andersonsafre/Low-Cost-Dendrometer/hardware/dendro_bracket_v1.pdf

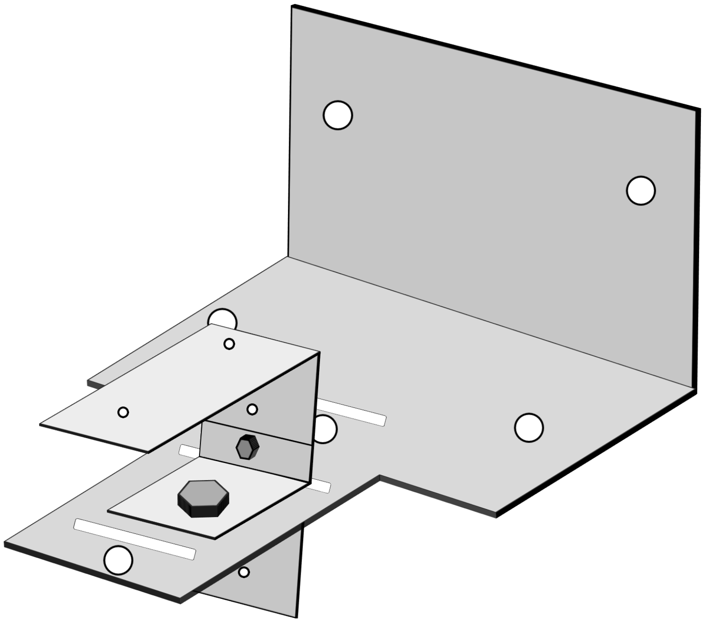
[picture p1: figure]

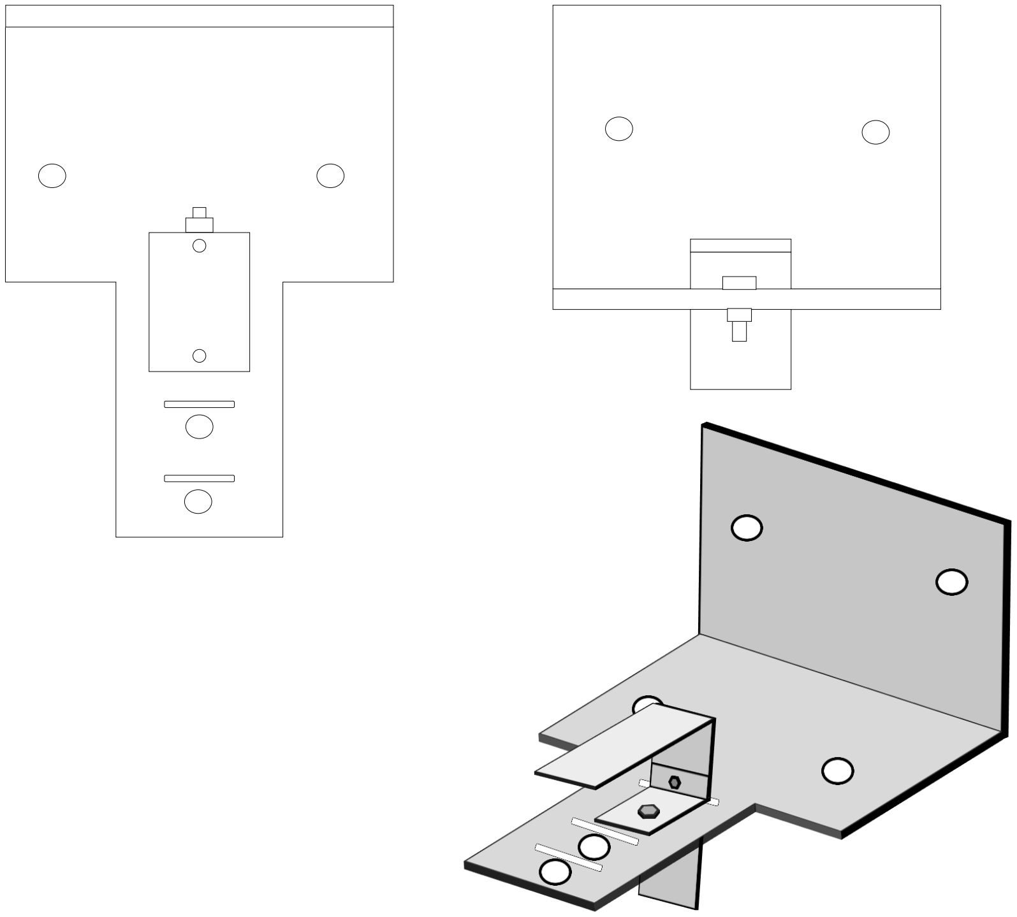
[picture p2: figure]

Part B | Part A

Part C

ø1/4”

# Ø2 mm

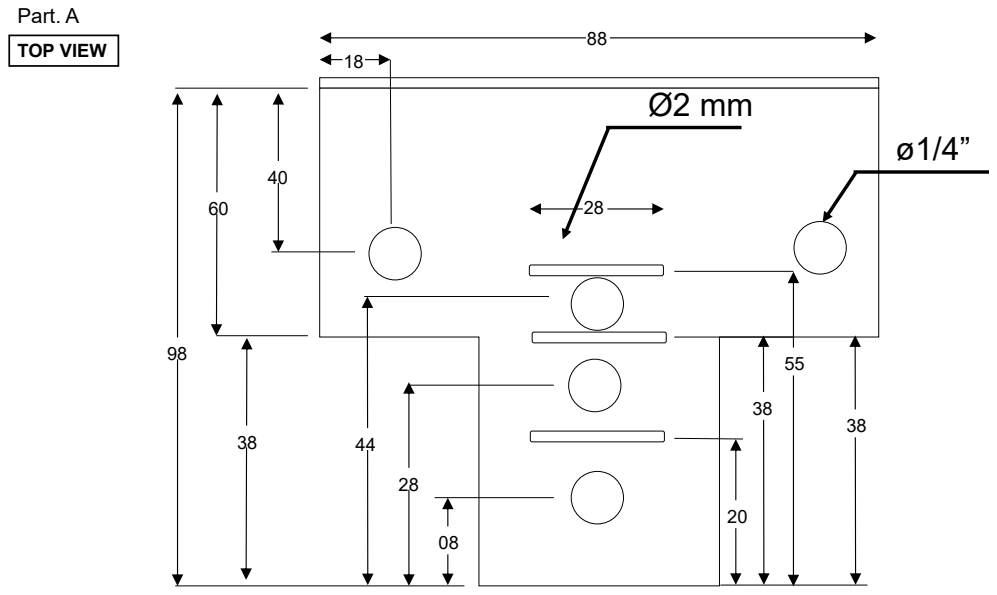
[picture p3: page 3]
TOP VIEW; Part. A

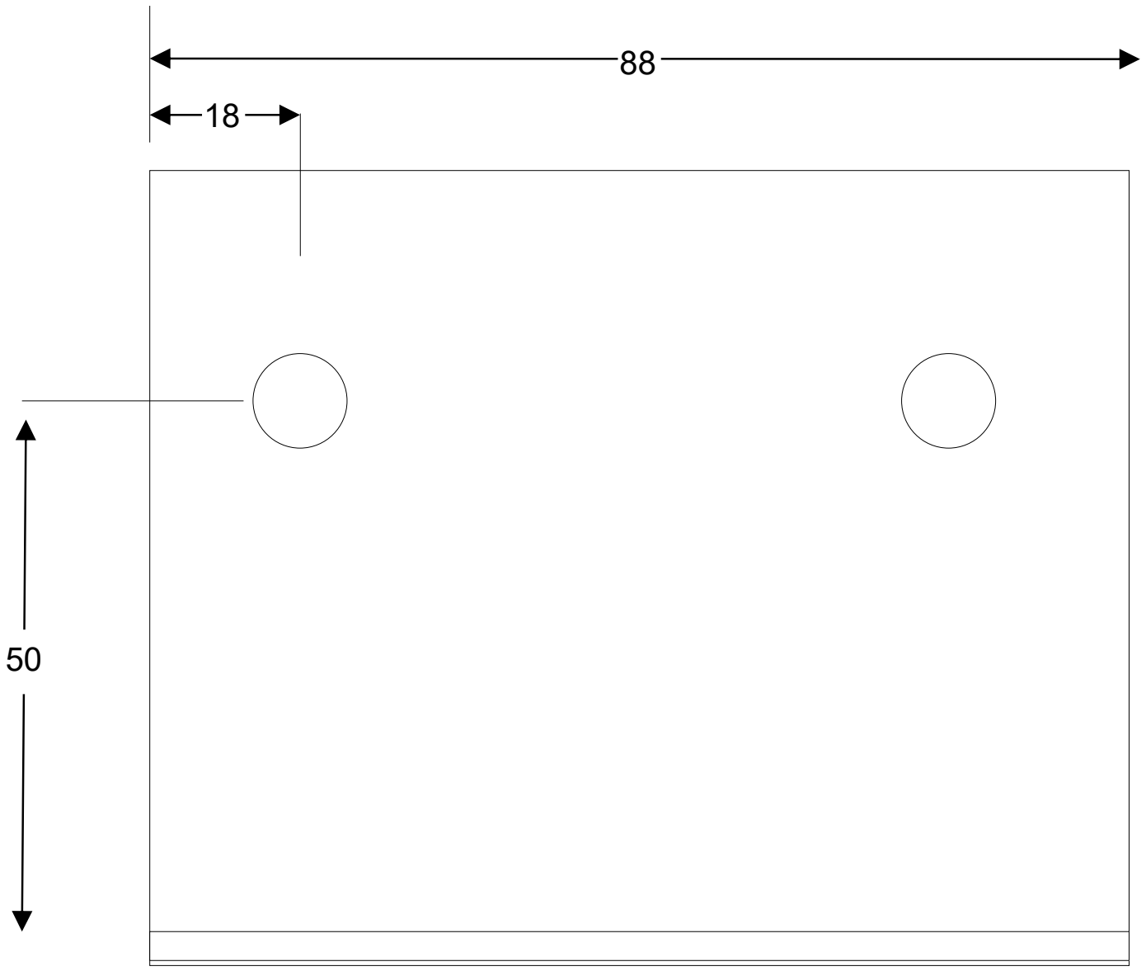
[picture p4: figure]

FRONT VIEW

Part. A

78

SIDE VIEW

Part. A

98

78

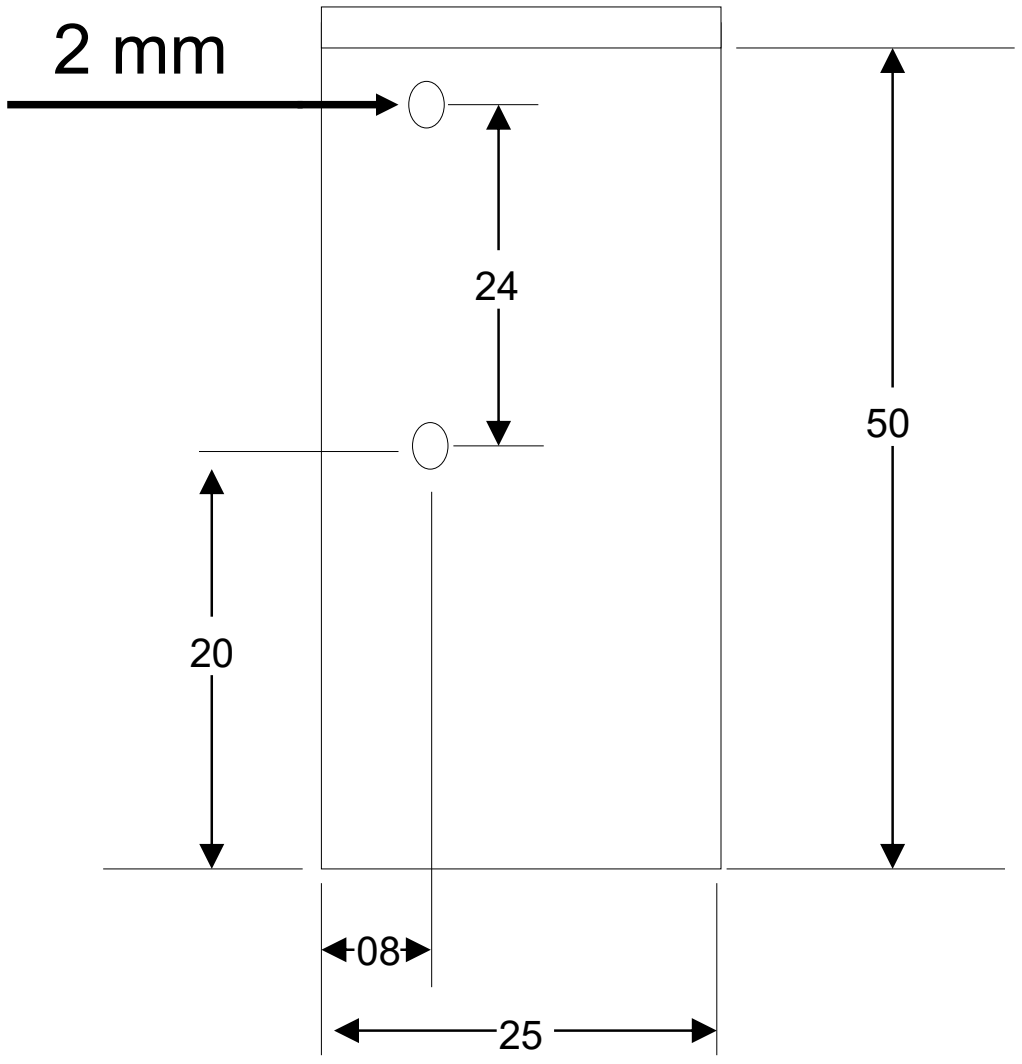
[picture p5: figure]

TOP VIEW

Part. B

FRONT VIEW

Part. B

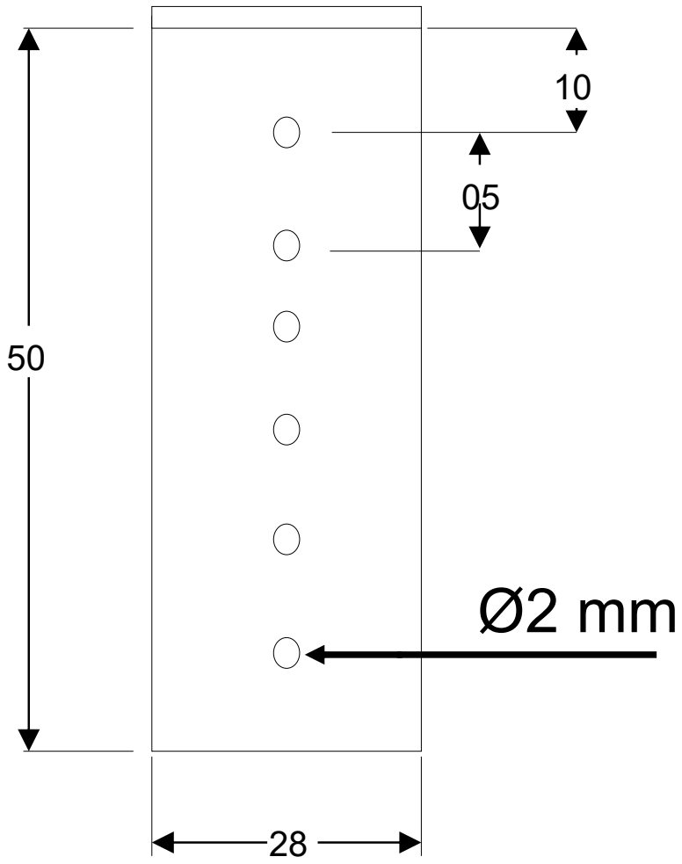
[picture p6: figure]

SIDE VIEW

Part. B

50

50

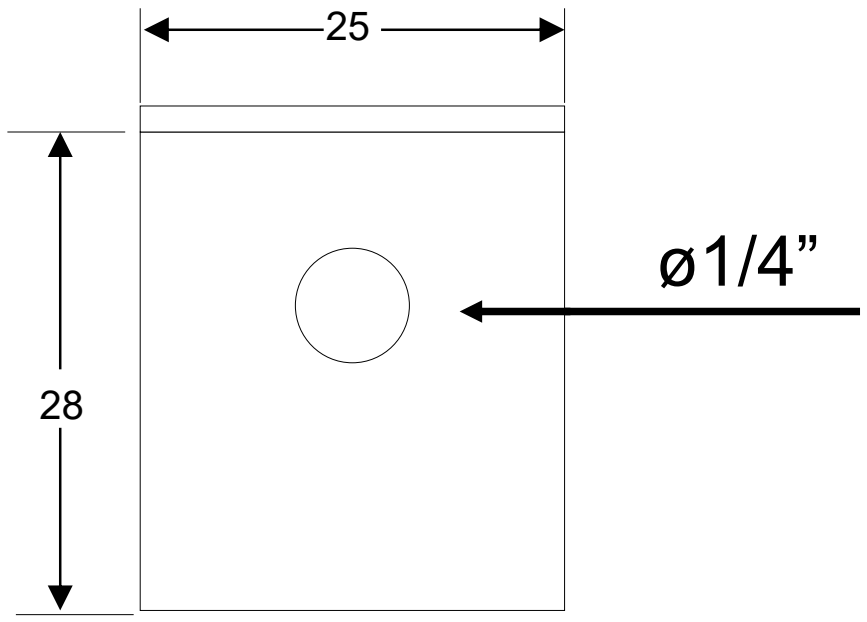
[picture p7: figure]

TOP VIEW

Part. C

FRONT VIEW

Part. C

# Ø2 mm

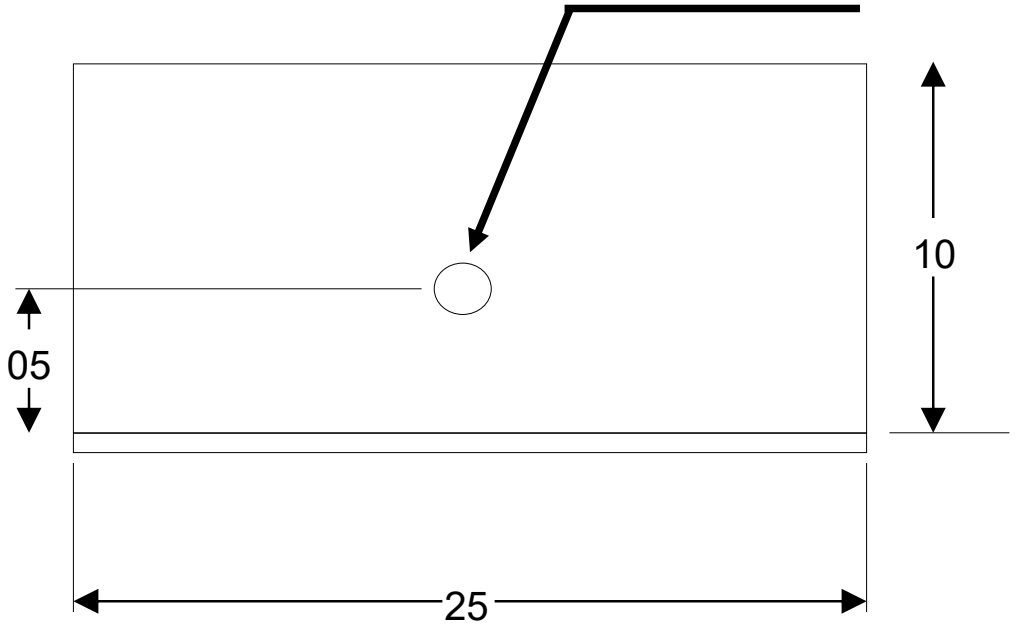
[picture p8: figure]

SIDE VIEW

Part. C

28

10
