andersonsafre/Low-Cost-Dendrometer/hardware/wiring_diagram.jpg

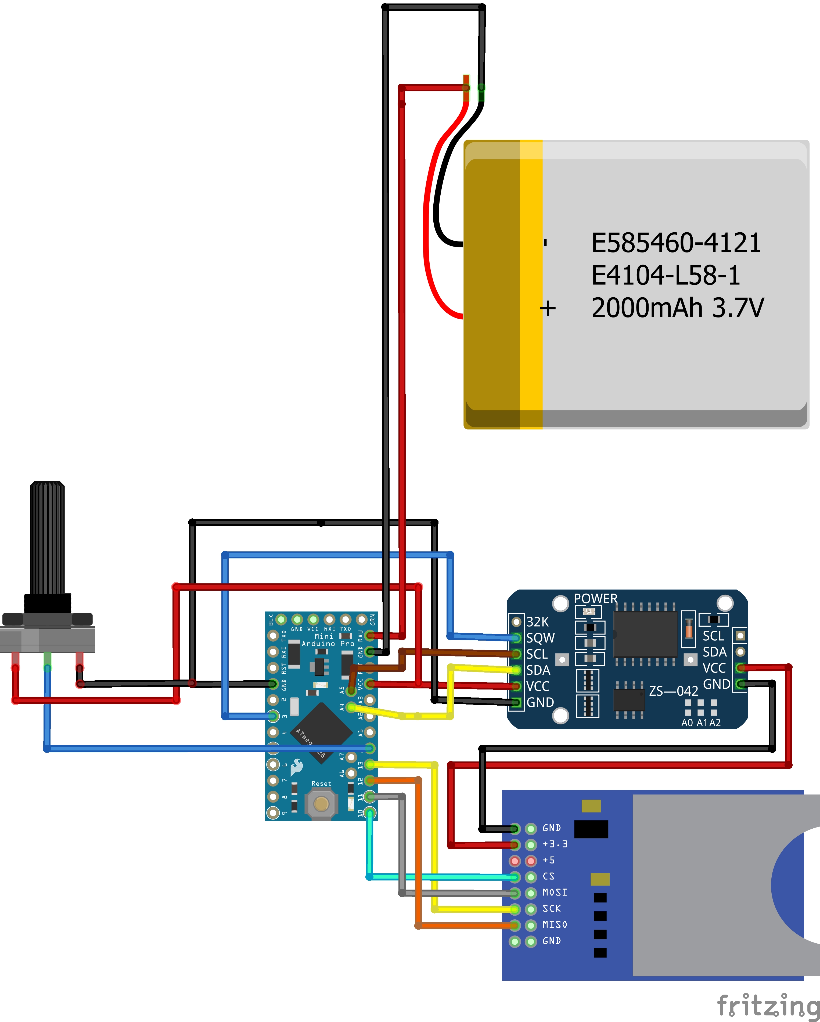
hardware/wiring_diagram.jpg
